jerusalem-science-museum/energy-heating-wires/תמונות תרמיות/IMG_0070.bmp

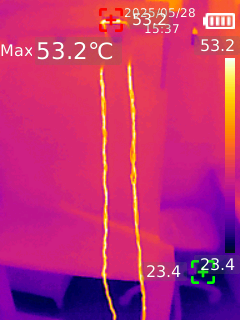
תמונות תרמיות/IMG_0070.bmp
