jerusalem-science-museum/energy-heating-wires/תמונות תרמיות/IMG_0062.bmp

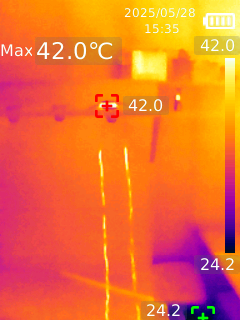
תמונות תרמיות/IMG_0062.bmp
