jerusalem-science-museum/energy-heating-wires/camere_IR/datasheet/link.txt

command instruction
https://ivcan.com/how-to-modify-color-zoom-of-fpv-thermal-imaging-camera/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

App
https://www.stoneitech.com/download/uart-communication-software-sscom32-2/
