jerusalem-science-museum/energy-heating-wires/שרטוטים/arduino_7seg.jpg

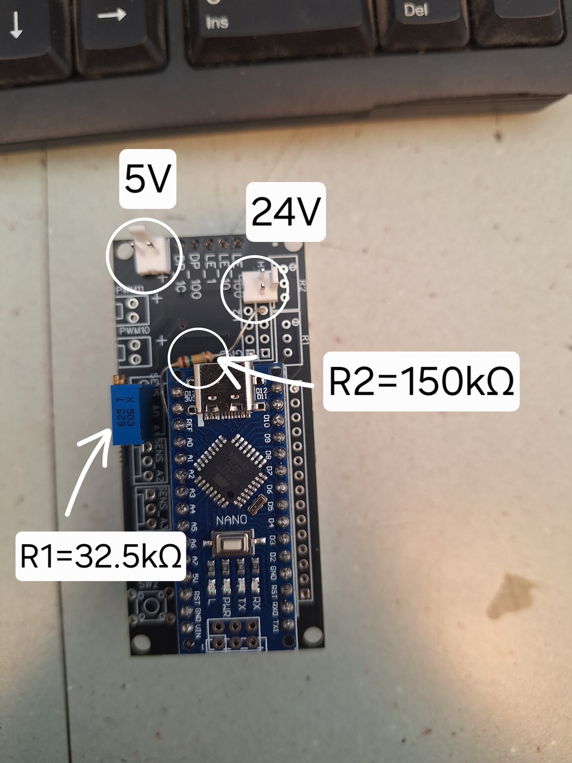
שרטוטים/arduino_7seg.jpg
