jerusalem-science-museum/energy-heating-wires/שרטוטים/Heating_wires2.png

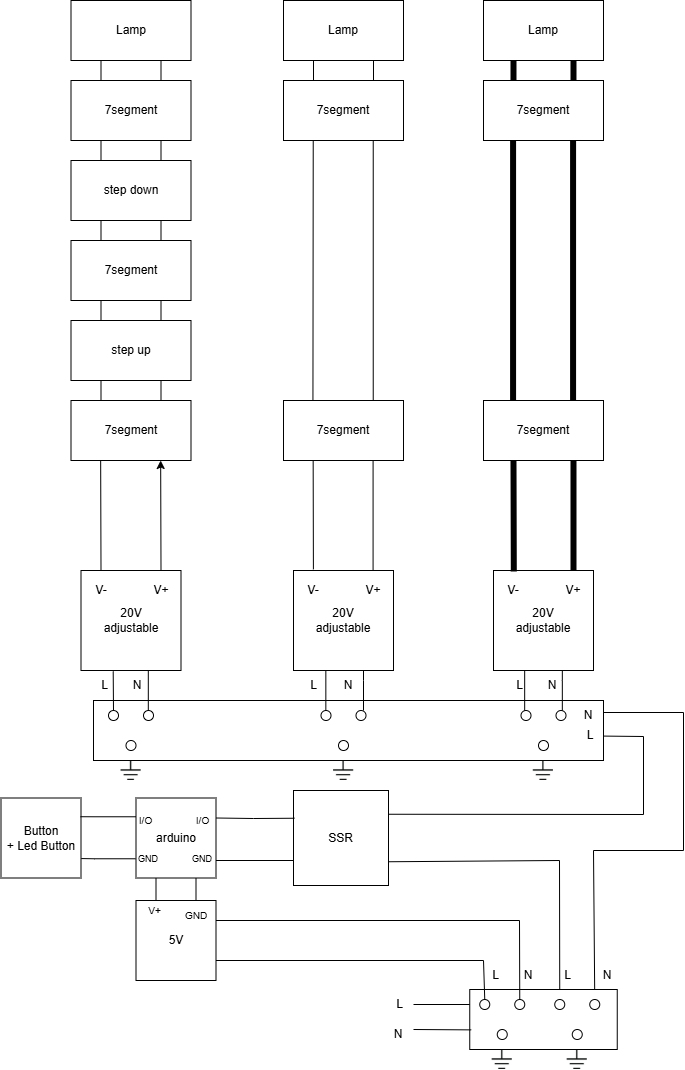
שרטוטים/Heating_wires2.png
