jerusalem-science-museum/energy-heating-wires/שרטוטים/led_2.5V.jpg

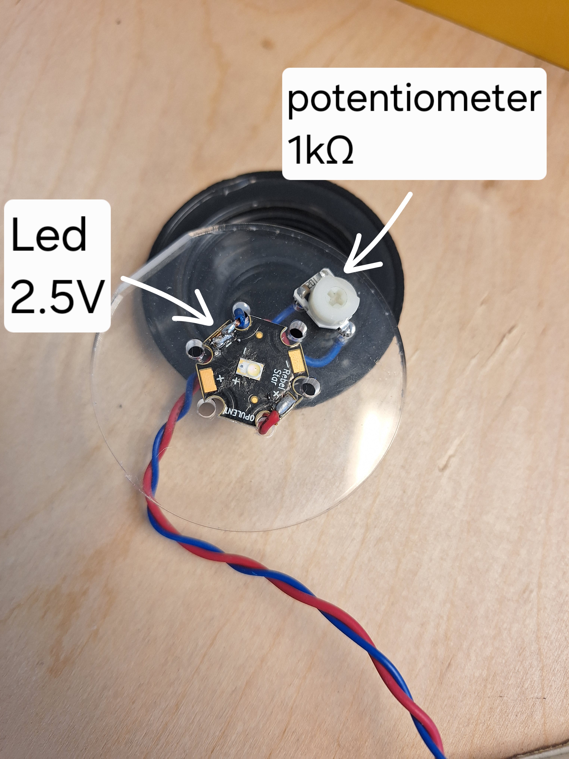
שרטוטים/led_2.5V.jpg
