jerusalem-science-museum/energy-heating-wires/שרטוטים/Screenshot 2025-01-30 223851.png

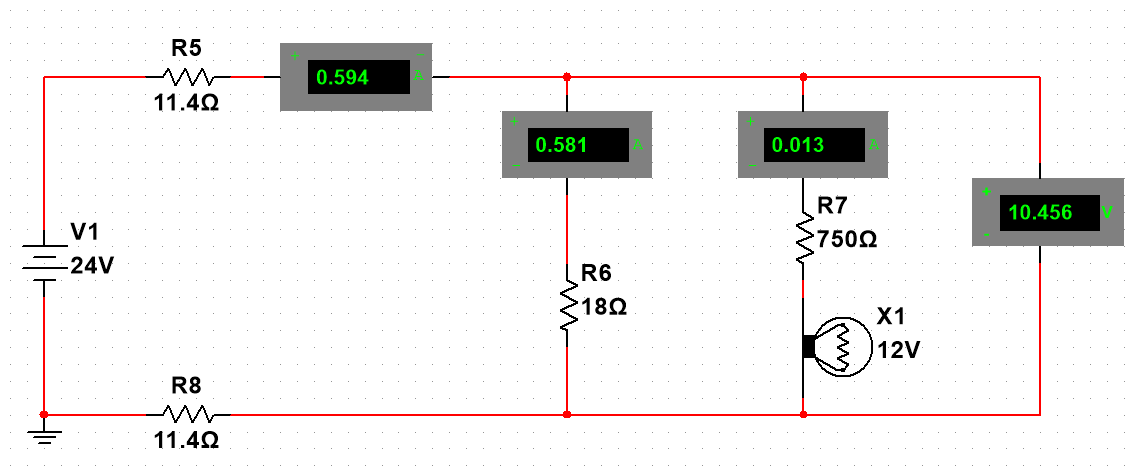
שרטוטים/Screenshot 2025-01-30 223851.png
