jerusalem-science-museum/energy-heating-wires/שרטוטים/Screenshot 2025-01-30 224033.png

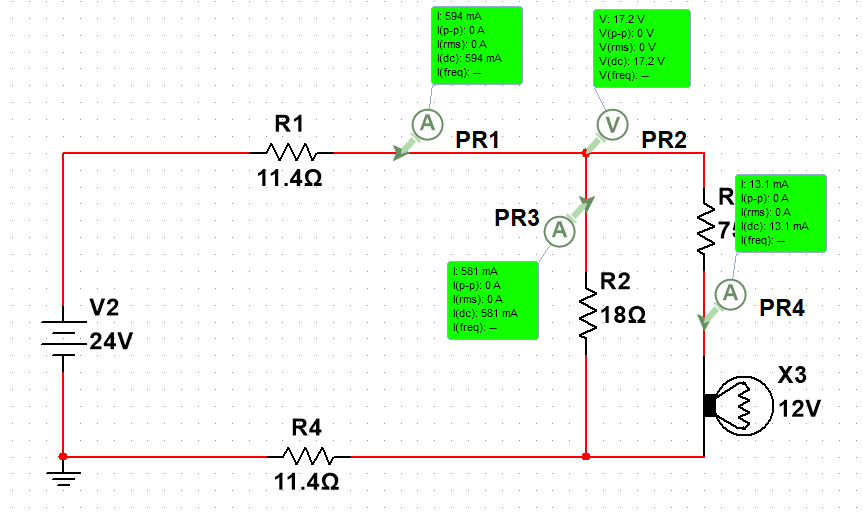
שרטוטים/Screenshot 2025-01-30 224033.png
