jerusalem-science-museum/energy-heating-wires/שרטוטים/shematic_arduino.jpg

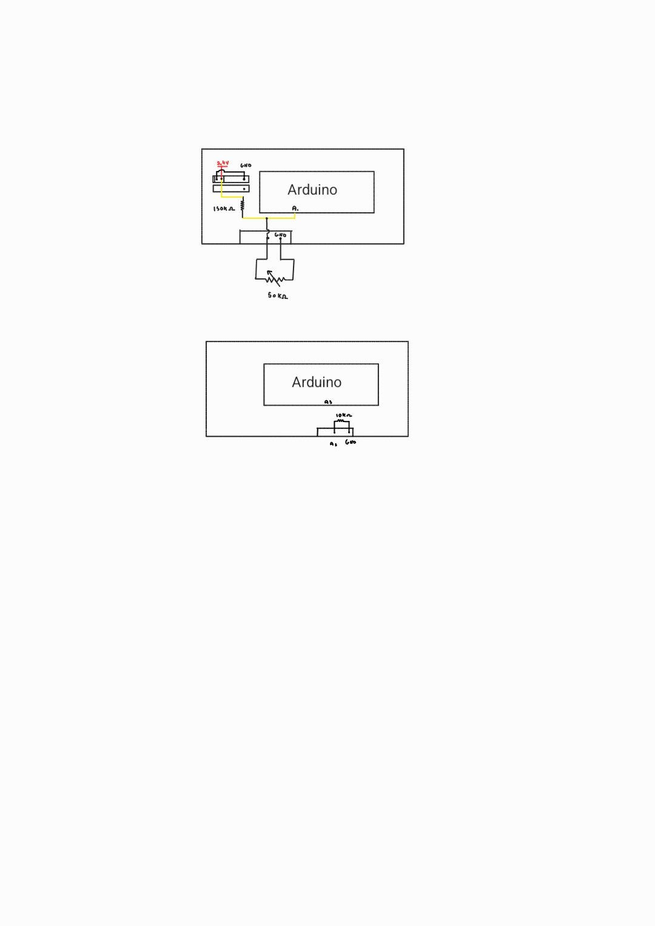
שרטוטים/shematic_arduino.jpg
