jerusalem-science-museum/energy-heating-wires/שרטוטים/נגד עומס.jpg

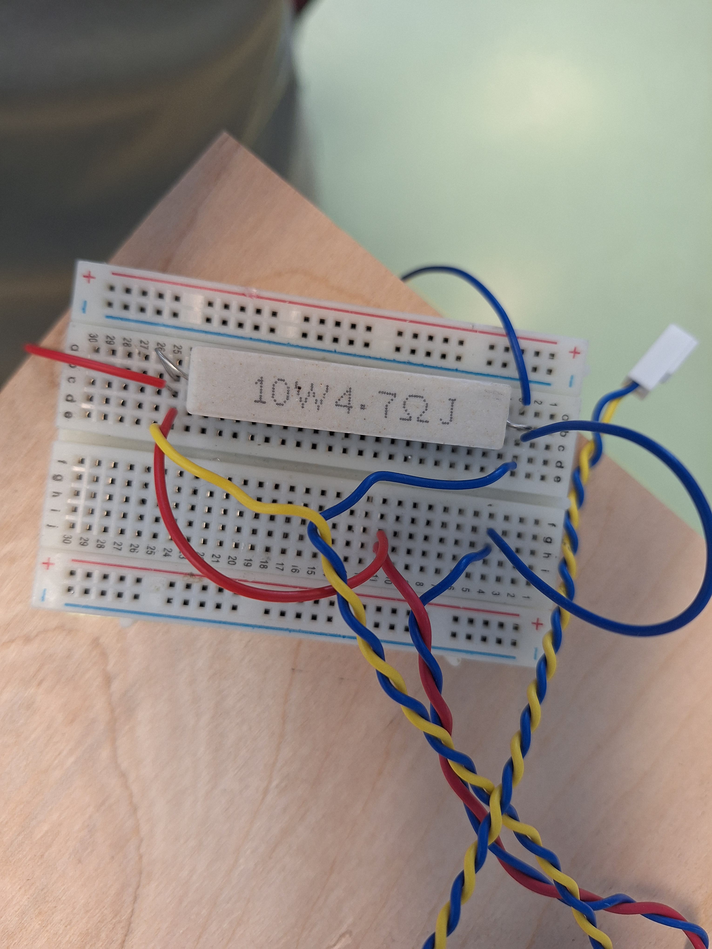
שרטוטים/נגד עומס.jpg
