jerusalem-science-museum/energy-heating-wires/תמונות תרמיות/IMG_0063.bmp

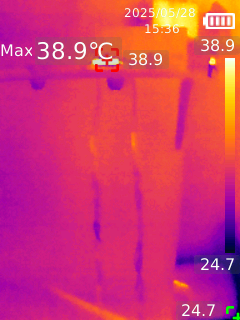
תמונות תרמיות/IMG_0063.bmp
