jerusalem-science-museum/energy-heating-wires/תמונות תרמיות/IMG_0064.bmp

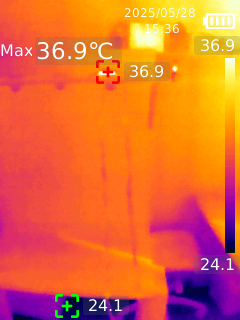
תמונות תרמיות/IMG_0064.bmp
