jerusalem-science-museum/energy-heating-wires/תמונות תרמיות/IMG_0065.bmp

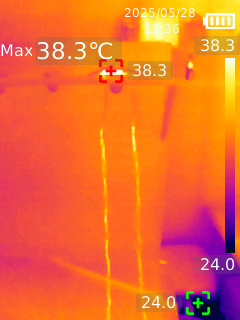
תמונות תרמיות/IMG_0065.bmp
