jerusalem-science-museum/energy-heating-wires/תמונות תרמיות/IMG_0066.bmp

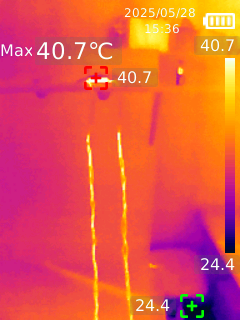
תמונות תרמיות/IMG_0066.bmp
