jerusalem-science-museum/energy-heating-wires/תמונות תרמיות/IMG_0067.bmp

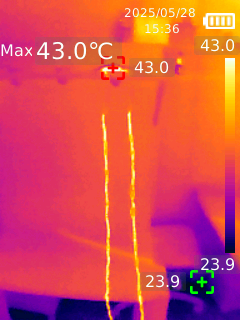
תמונות תרמיות/IMG_0067.bmp
