jerusalem-science-museum/energy-heating-wires/תמונות תרמיות/IMG_0068.bmp

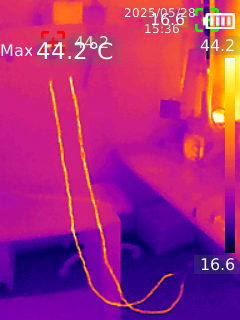
תמונות תרמיות/IMG_0068.bmp
