jerusalem-science-museum/energy-heating-wires/תמונות תרמיות/IMG_0069.bmp

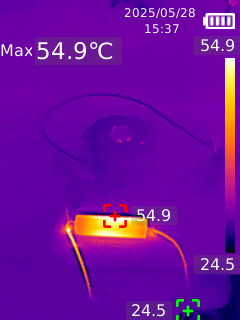
תמונות תרמיות/IMG_0069.bmp
