jerusalem-science-museum/energy-heating-wires/תמונות תרמיות/IMG_0071.bmp

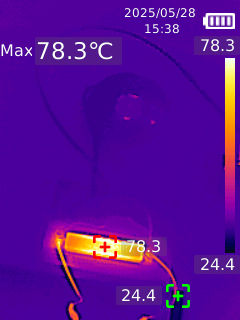
תמונות תרמיות/IMG_0071.bmp
