jerusalem-science-museum/energy-heating-wires/תמונות תרמיות/IMG_0072.bmp

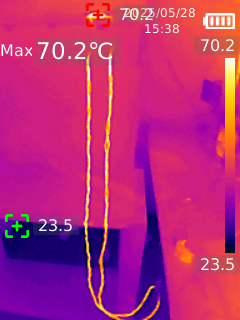
תמונות תרמיות/IMG_0072.bmp
