jerusalem-science-museum/energy-heating-wires/תמונות תרמיות/IMG_0073.bmp

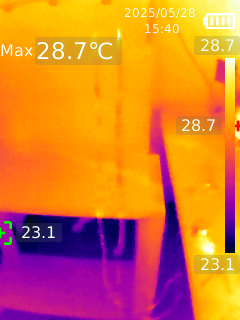
תמונות תרמיות/IMG_0073.bmp
