jerusalem-science-museum/energy-heating-wires/שרטוטים/EN-2.3-060.pdf

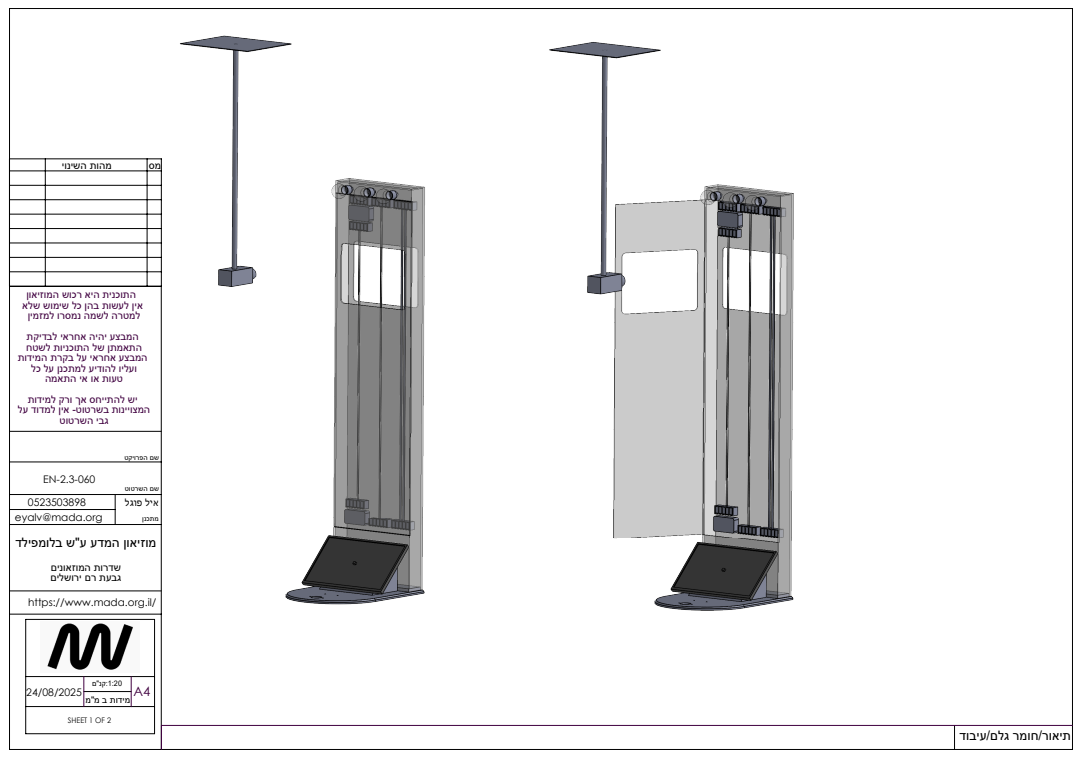
[picture p35: page 1]
SHEET 1 OF 2; שם השרטוט; שם הפרויקט; איל פוגל; מידות ב מ"מ

מס מהות השינוי

התוכנית היא רכוש המוזיאון
אין לעשות בהן כל שימוש שלא
למטרה לשמה נמסרו למזמין
המבצע יהיה אחראי לבדיקת
התאמתן של התוכניות לשטח
המבצע אחראי על בקרת המידות
ועליו להודיע למתכנן על כל
טעות או אי התאמה
יש להתייחס אך ורק למידות
המצויינות בשרטוט- אין למדוד על
גבי השרטוט

eyalv@mada.org
מוזיאון המדע ע"ש בלומפילד
שדרות המוזאונים
גבעת רם ירושלים
https://www.mada.org.il/

תיאור/חומר גלם/עיבוד

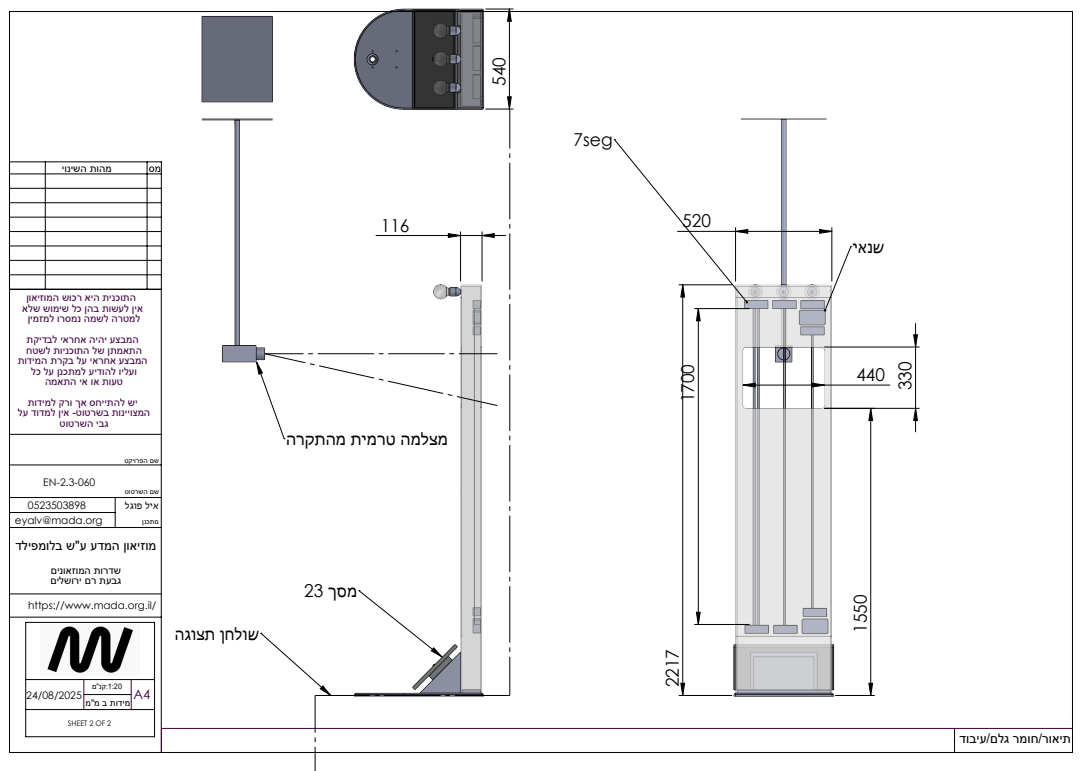
[picture p36: page 2]
מסך 23; שולחן תצוגה; SHEET 2 OF 2; שם השרטוט; שם הפרויקט; איל פוגל; מידות ב מ"מ

מס מהות השינוי

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

מצלמה טרמית מהתקרה

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

תיאור/חומר גלם/עיבוד
