jerusalem-science-museum/energy-heating-wires/(list of files, drawings)

Other design files:
camere_IR/easyEda camera_IR/Camera_IR/PCB_Camera_IR.json
camere_IR/easyEda camera_IR/Camera_IR_esp/PCB_Camera_IR_esp.json
סיכום/calcul_multisim.ms14
