jerusalem-science-museum/energy-heating-wires/code arduino/voltmeter/Const.h

#ifndef Const
#define Const


#define SERIAL_BAUD_RATE (115200)
#define BCD_A (3) // Output to BCD_A (4511)
#define BCD_B (4) // Output to BCD_B (4511)
#define BCD_C (5) // Output to BCD_C (4511)
#define BCD_D (6) // Output to BCD_D (4511)

#define LE_CENTURIES (7) // Output Left (100th) digit LE (negative pulse) used as 10th
#define LE_DOZENS (8)
#define LE_UNITS (9) // Output right (10th) digit LE (negative pulse) used as units 


//#define VOLTMETER_PIN A1
#define VOLTMETER_PIN A1
/*
/*
*==========Arduino Nano pinout====== 
 *                      _______
 *                 TXD-|       |-Vin 
 *                 RXD-|       |-Gnd  
 *                 RST-|       |-RST
 *                 GND-|       |-+5V  
 *                  D2-|       |-A7  
 *           BCD A  D3-|       |-A6  
 *           BCD B  D4-|       |-A5  
 *           BCD C  D5-|       |-A4  
 *           BCD D  D6-|       |-A3  voltmeter after wire
 *    LE_CENTURIES  D7-|       |-A2  
 *       LE_DOZENS  D8-|       |-A1  voltmeter 24V
 *        LE_UNITS  D9-|       |-A0 
 *                 D10-|       |-Ref
 *                 D11-|       |-3.3V   
 *                 D12-|       |-D13
 *                      --USB--        
 */

//R2 = 149200 ->conected to 24V and A1
//R1 = 32500 -> connected to Gnd and A1

//////////////variable for 7seg///////////////
const int8_t  Number_OF_7SEG = 3;
const int8_t RIGHT_DIGIT = 1;
const int8_t MIDDLE_DIGIT = 2;
const int8_t LEFT_DIGIT = 3;
const float UNIT_CALIBRATION = 11;
int Digit_3_To_Display = 0;// Left (100th) digit to disply - used as 10th
int Digit_2_To_Display = 0;// Mid right (10th) digit to disply  - used as units 
int Digit_1_To_Display = 0;// rigth (external unit) digit to disply - not used for winf tunnel
///////////////////////////////////////////////


const float Vref = 5;
const float BIT_RESOLUTION = 1023;
const float VIN_MAX = 24;
float Vin;
float Vout;



#endif
