jerusalem-science-museum/energy-heating-wires/(commit log)

2026-02-16 new פןב
2026-05-14 תמונות
